bgkatz/USBtoCAN/eagle files/2019-08-08T161906.xlsx

Index | Quantity | Part Number | Manufacturer Part Number | Description | Customer Reference | Available | Backorder | Unit Price | Extended Price USD
1 | 1 | WM3895CT-ND | 0548190589 | CONN RCPT MINI USB B 5POS SMD RA |  | 1 | 0 | 1.39 | 1.39
2 | 1 | 952-3447-ND | M80-9400605 | CONN RCPT 6P CRIMP 24-28AWG GOLD |  | 1 | 0 | 14.39 | 14.39
3 | 1 | 952-1024-5-ND | M80-5400642 | CONN HEADER R/A 6POS 2MM |  | 1 | 0 | 17.27 | 17.27
4 | 1 | 811-3195-ND | CRE1S0505S3C | DC DC CONVERTER 5V 1W |  | 1 | 0 | 2.69 | 2.69
5 | 1 | 336-2570-ND | SI8621BB-B-IS | DGTL ISO 2.5KV GEN PURP 8SOIC |  | 1 | 0 | 1.53 | 1.53
6 | 1 | 497-15376-ND | STM32F446RET6 | IC MCU 32BIT 512KB FLASH 64LQFP |  | 1 | 0 | 8.59 | 8.59
7 | 1 | 490-17961-1-ND | CSTNE8M00GH5C000R0 | CERAMIC RES 8.0000MHZ 33PF SMD |  | 1 | 0 | 0.36 | 0.36
8 | 1 | 455-1807-1-ND | SM07B-SRSS-TB(LF)(SN) | CONN HEADER SMD R/A 7POS 1MM |  | 1 | 0 | 0.83 | 0.83
9 | 2 | 553-2384-1-ND | PE-0603FB601ST | FERRITE BEAD 600 OHM 0603 1LN |  | 2 | 0 | 0.1 | 0.20
10 | 2 | 311-2217-1-ND | RT0402DRE0710KL | RES SMD 10K OHM 0.5% 1/16W 0402 |  | 2 | 0 | 0.2 | 0.40
11 | 2 | 490-14306-1-ND | GRM155R61A475MEAAD | CAP CER 4.7UF 10V X5R 0402 |  | 2 | 0 | 0.23 | 0.46
12 | 11 | 1276-1443-1-ND | CL05A104MP5NNNC | CAP CER 0.1UF 10V X5R 0402 |  | 11 | 0 | 0.019 | 0.21
13 | 1 | 1276-1448-1-ND | CL05A105MP5NNNC | CAP CER 1UF 10V X5R 0402 |  | 1 | 0 | 0.1 | 0.10
14 | 1 | 768-1135-1-ND | FT230XS-R | IC USB SERIAL BASIC UART 16SSOP |  | 1 | 0 | 2.04 | 2.04
15 | 1 | 160-1447-1-ND | LTST-C191KRKT | LED RED CLEAR SMD |  | 1 | 0 | 0.28 | 0.28
16 | 1 | LM1117MPX-3.3/NOPBCT-ND | LM1117MPX-3.3/NOPB | IC REG LIN 3.3V 800MA SOT223-4 |  | 1 | 0 | 1.14 | 1.14
17 | 1 | MCP2562-E/SN-ND | MCP2562-E/SN | IC TXRX CAN 8SOIC |  | 1 | 0 | 0.93 | 0.93
18 | 1 | 311-200JRCT-ND | RC0402JR-07200RL | RES SMD 200 OHM 5% 1/16W 0402 |  | 1 | 0 | 0.1 | 0.10
19 | 1 | 311-120JRCT-ND | RC0402JR-07120RL | RES SMD 120 OHM 5% 1/16W 0402 |  | 1 | 0 | 0.1 | 0.10
20 | 2 | YAG3343CT-ND | RT0402FRE0727RL | RES SMD 27 OHM 1% 1/16W 0402 |  | 2 | 0 | 0.1 | 0.20
21 | 1 | 1276-6830-1-ND | CL05A106MP8NUB8 | CAP CER 10UF 10V X5R 0402 |  | 1 | 0 | 0.47 | 0.47
22 | 1 | 311-1703-1-ND | CC0402KRX7R6BB103 | CAP CER 10000PF 10V X7R 0402 |  | 1 | 0 | 0.1 | 0.10
23 | 2 | 399-14455-1-ND | C0402C470K8GAC7867 | CAP CER 47PF 10V NP0 0402 |  | 2 | 0 | 0.35 | 0.70
