bgkatz/USBtoCAN/eagle files/usb_to_can.brd

## EAGLE design eagle files/usb_to_can.brd (2019-08-08)

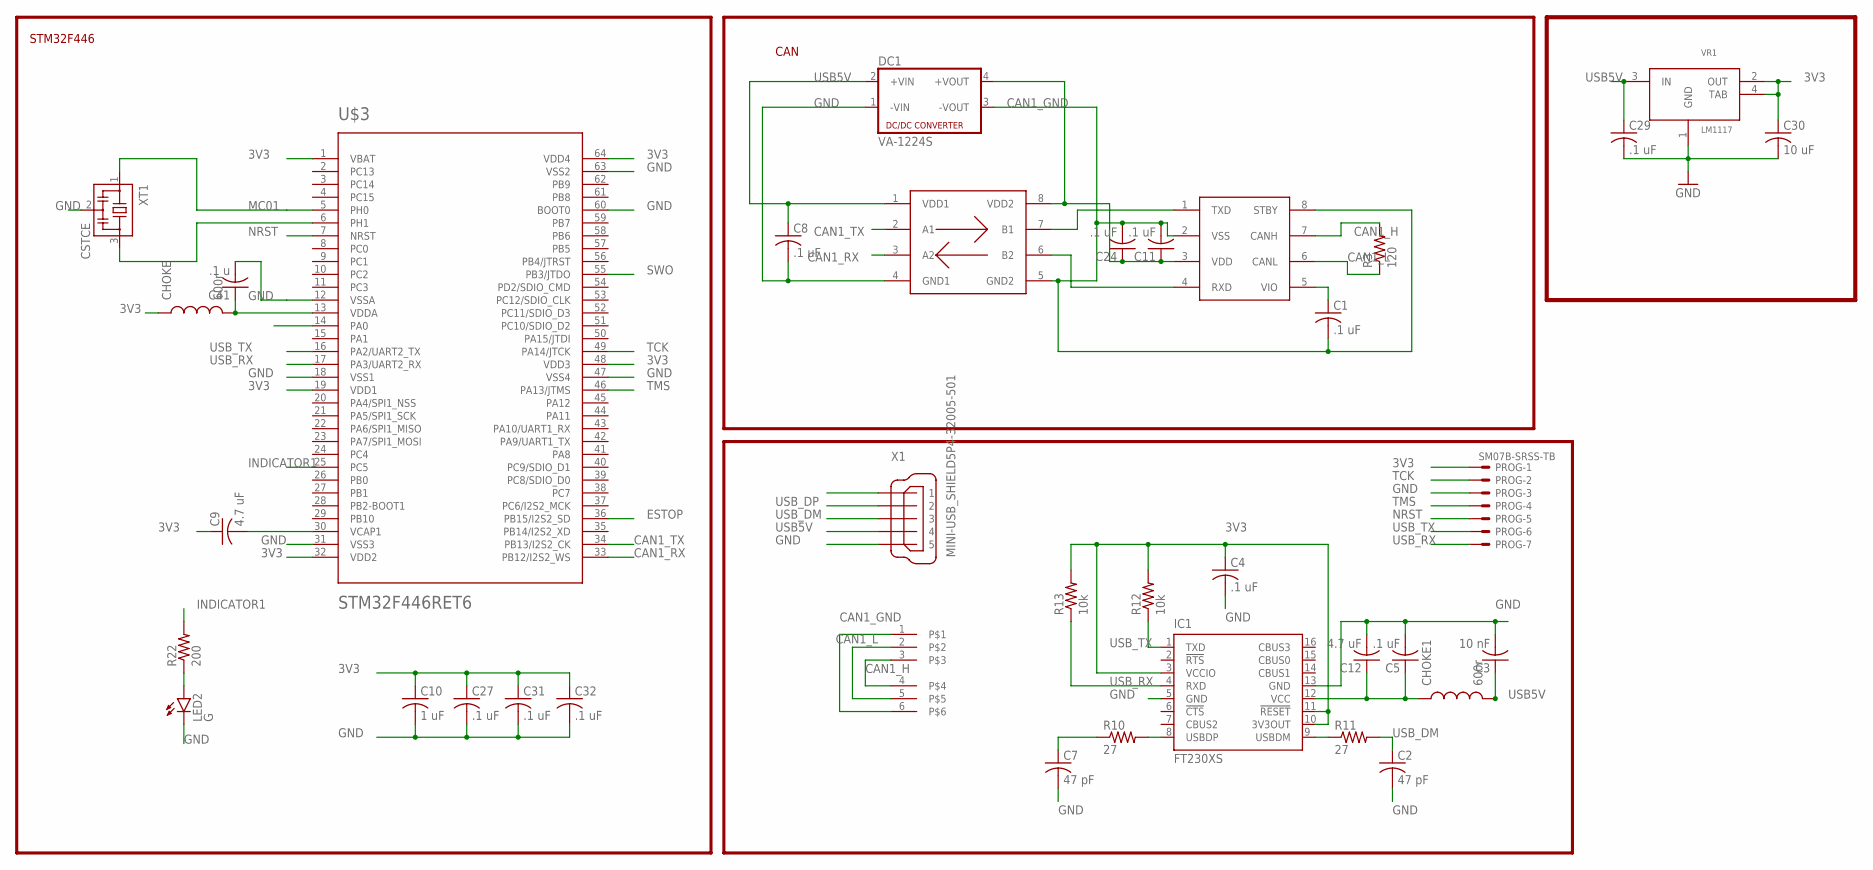
[picture p1: schematic usb_to_can.sch]

Parts:
C1, C4, C5, C8, C11, C24, C27, C29, C31, C32: .1 uF; C0402K
C2, C7: 47 pF; C0402K
C3: 10 nF; C0402K
C9, C12: 4.7 uF; C0402K
C10: 1 uF; C0402K
C30: 10 uF; C0402K
C41: .1 u; C0402K
CHOKE, CHOKE1: 600r; 0603
DC1: VA-1224S; 4SIL
IC1: FT230XS; SSOP16
LED2: G; LED-0603
PROG: SM07B-SRSS-TB
R3: 120; R0402
R10, R11: 27; R0402
R12, R13: 10k; R0402
R22: 200; R0402
U$1: 6-PIN; M80-5400642
U$3: STM32F446RET6; TQFP64
U$4: MCP2561; SO08
U$8: SI8410; SO08
VR1: LM1117; SOT-223
X1: MINI-USB_SHIELD5P4-32005-501; 32005-501
XT1: CSTCE

Connections:
3V3: C4.1, C9.1, C10.1, C27.1, C30.1, C31.1, C32.1, CHOKE.1, IC1.3 (VCCIO), IC1.10 (3V3OUT), IC1.11 (!RESET), PROG.1, R12.2, R13.2, U$3.1 (VBAT), U$3.19 (VDD1), U$3.32 (VDD2), U$3.48 (VDD3), U$3.64 (VDD4), VR1.2 (OUT), VR1.4 (TAB)
CAN1_GND: C1.2, C11.2, C24.2, DC1.3 (-VOUT), U$1.1, U$1.6, U$4.2 (VSS), U$4.8 (STBY), U$8.5 (GND2)
CAN1_H: R3.2, U$1.3, U$1.4, U$4.7 (CANH)
CAN1_L: R3.1, U$1.2, U$1.5, U$4.6 (CANL)
CAN1_RX: U$3.33 (PB12/I2S2_WS), U$8.3 (A2)
CAN1_TX: U$3.34 (PB13/I2S2_CK), U$8.2 (A1)
ESTOP: U$3.36 (PB15/I2S2_SD)
GND: C2.2, C3.2, C4.2, C5.2, C7.2, C8.2, C10.2, C12.2, C27.2, C29.2, C30.2, C31.2, C32.2, C41.2, DC1.1 (-VIN), IC1.5 (GND), IC1.13 (GND), LED2.C, PROG.3, U$3.12 (VSSA), U$3.18 (VSS1), U$3.31 (VSS3), U$3.47 (VSS4), U$3.60 (BOOT0), U$3.63 (VSS2), U$8.4 (GND1), VR1.1 (GND), X1.5, XT1.2
INDICATOR1: R22.2, U$3.25 (PC5)
MC01: U$3.5 (PH0), XT1.1
unnamed: C41.1, CHOKE.2, U$3.13 (VDDA)
unnamed: C9.2, U$3.30 (VCAP1)
unnamed: C1.1, U$4.5 (VIO)
unnamed: C5.1, C12.1, CHOKE1.1, IC1.12 (VCC)
unnamed: IC1.8 (USBDP), R10.2
unnamed: C11.1, C24.1, DC1.4 (+VOUT), U$4.3 (VDD), U$8.8 (VDD2)
unnamed: U$4.1 (TXD), U$8.7 (B1)
unnamed: IC1.9 (USBDM), R11.1
unnamed: U$4.4 (RXD), U$8.6 (B2)
unnamed: LED2.A, R22.1
unnamed: U$3.6 (PH1), XT1.3
NRST: PROG.5, U$3.7 (NRST)
SWO: U$3.55 (PB3/JTDO)
TCK: PROG.2, U$3.49 (PA14/JTCK)
TMS: PROG.4, U$3.46 (PA13/JTMS)
USB5V: C3.1, C8.1, C29.1, CHOKE1.2, DC1.2 (+VIN), U$8.1 (VDD1), VR1.3 (IN), X1.4
USB_DM: C2.1, R11.2, X1.3
USB_DP: C7.1, R10.1, X1.2
USB_RX: IC1.4 (RXD), PROG.7, R13.1, U$3.17 (PA3/UART2_RX)
USB_TX: IC1.1 (TXD), PROG.6, R12.1, U$3.16 (PA2/UART2_TX)

Notes on the sheet:
STM32F446
CAN

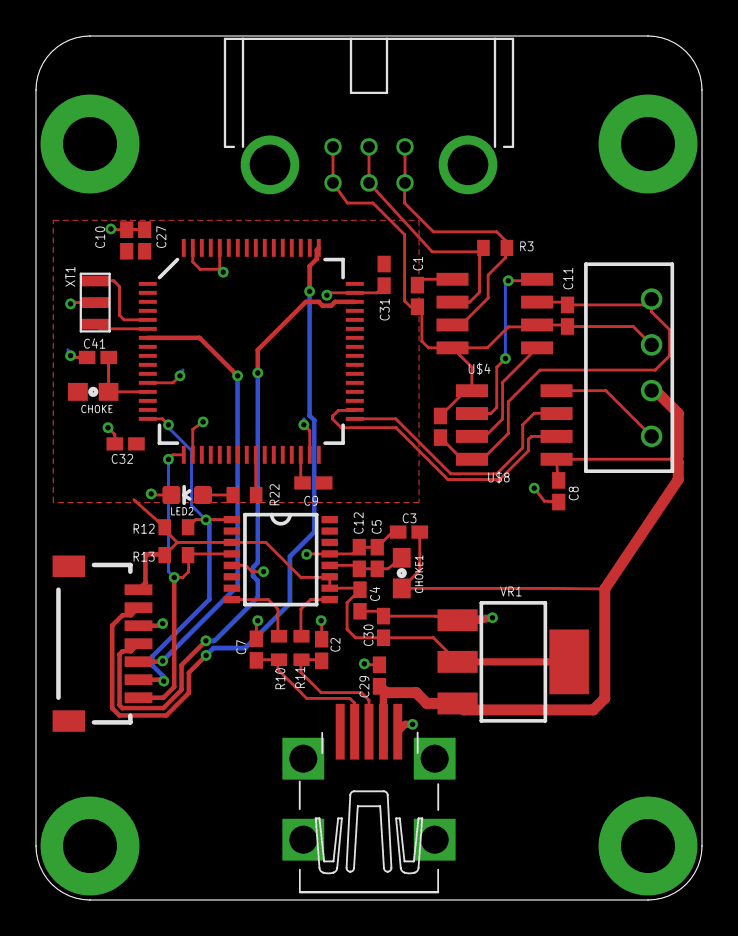
[picture p2: board usb_to_can.brd from above]

Board: 2 copper layers, 37.0 x 48.0 mm, 37 parts (0 on the bottom side), 28 nets.
