bgkatz/USBtoCAN/(commit log)

2019-08-08 committing files
    [usb_to_can.brd, usb_to_can.sch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]
2019-08-08 updated part values and BOM
    [2019-08-08T161906.xlsx, usb_to_can.brd, usb_to_can.sch]
2019-08-08 added python API
    [2019-08-08T161906.xlsx, usb_to_can.brd, usb_to_can.sch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]
2019-08-08 added digikey cart link to bom
